cmccurley22/3DScanner/README.md

# 3D Scanner

A Principles of Integrated Engineering mini-project by Kate McCurley, [Oliver Buchwald](https://github.com/oilverb), and [Maya Cranor](https://github.com/crane919)

View our project report [here](https://github.com/cmccurley22/3DScanner/blob/main/PIE_mini_proj_2.pdf)
